NithanNguyen/receptionist_robot/meshes/hoverboard_motor_assembly.stl

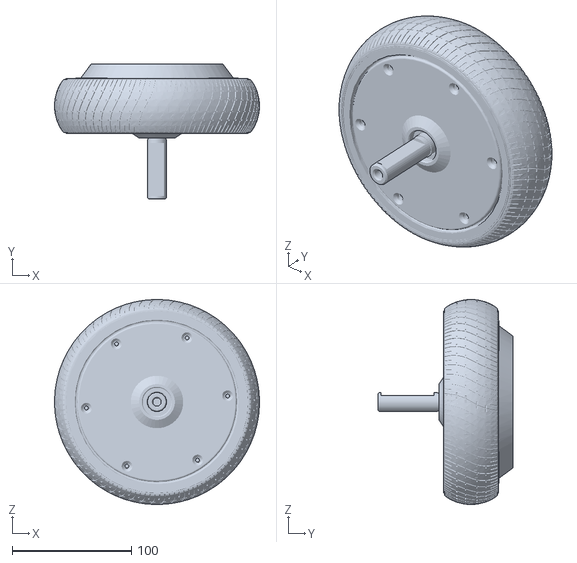
[picture p1: CAD file, 2026-10-13]
meshes/hoverboard_motor_assembly.stl
172.0 x 113.4 x 172.0
