NithanNguyen/receptionist_robot/meshes/RPLiDAR_s2.stl

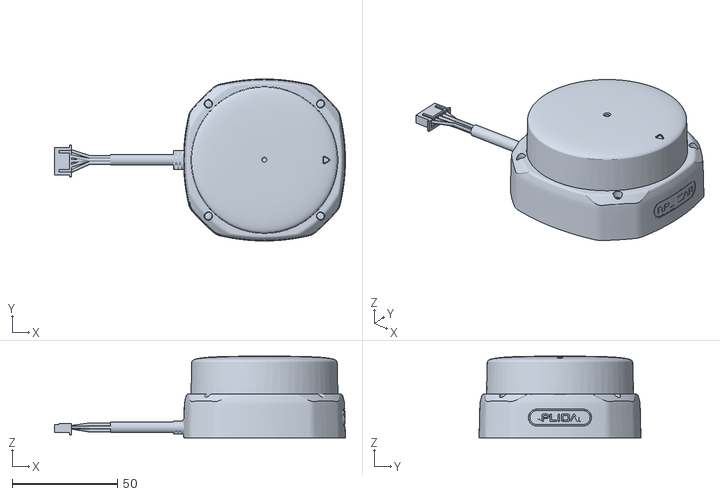
[picture p2: CAD file, 2026-10-13]
meshes/RPLiDAR_s2.stl
138.3 x 77.0 x 38.9
