NithanNguyen/receptionist_robot/meshes/Model.stl

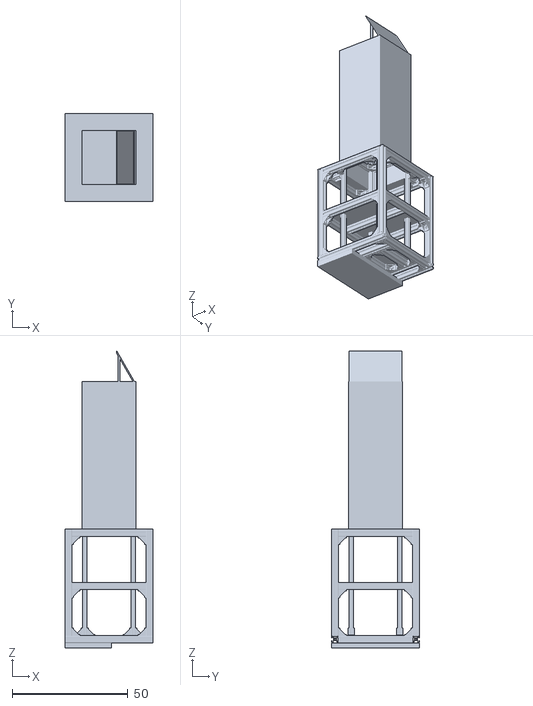
[picture p3: CAD file, 2026-10-13]
meshes/Model.stl
38.0 x 38.0 x 128.6
