NithanNguyen/receptionist_robot/meshes/BNO055_BPM280.stl

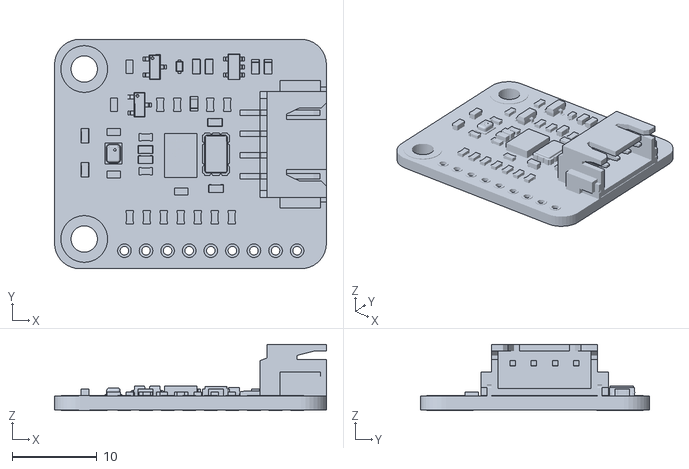
[picture p4: CAD file, 2026-10-13]
meshes/BNO055_BPM280.stl
32.0 x 27.0 x 7.80
