NithanNguyen/receptionist_robot/meshes/HY-SRF05.stl

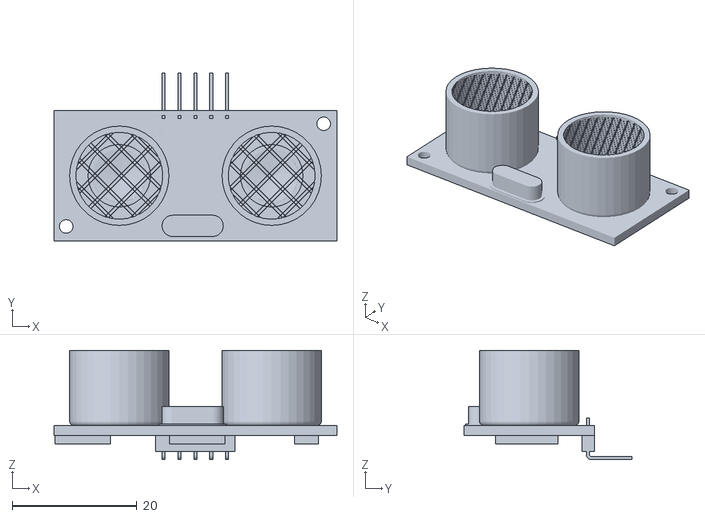
[picture p5: CAD file, 2026-10-13]
meshes/HY-SRF05.stl
45.3 x 26.8 x 17.5
