NithanNguyen/receptionist_robot/meshes/Model_v3.stl

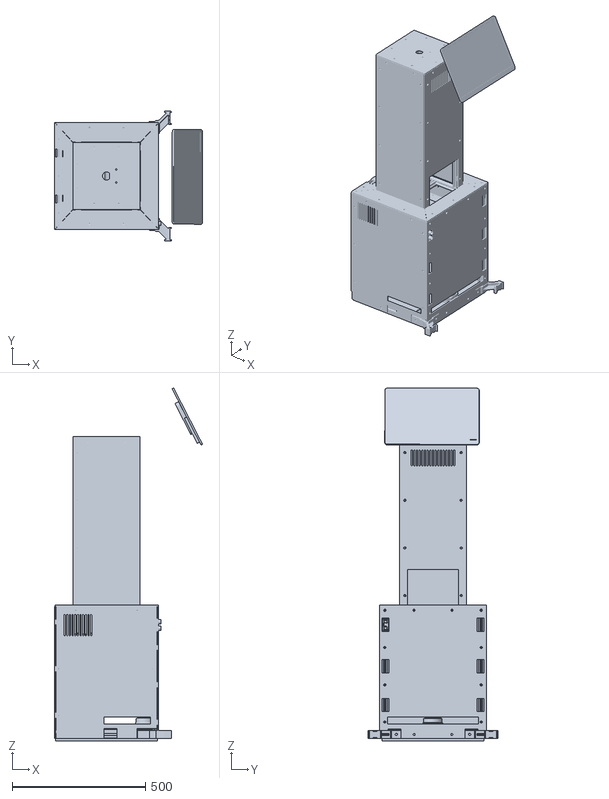
[picture p6: CAD file, 2026-10-13]
meshes/Model_v3.stl
556.7 x 486.8 x 1325.6
