NithanNguyen/receptionist_robot/meshes/wheel_left.stl

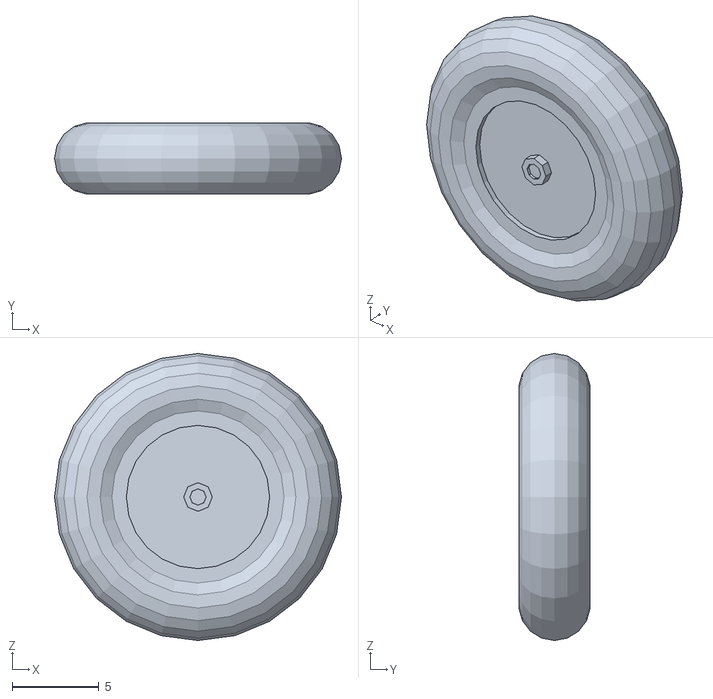
[picture p7: CAD file, 2026-10-13]
meshes/wheel_left.stl
16.5 x 4.11 x 16.5
