NithanNguyen/receptionist_robot/meshes/caster_wheel.stl

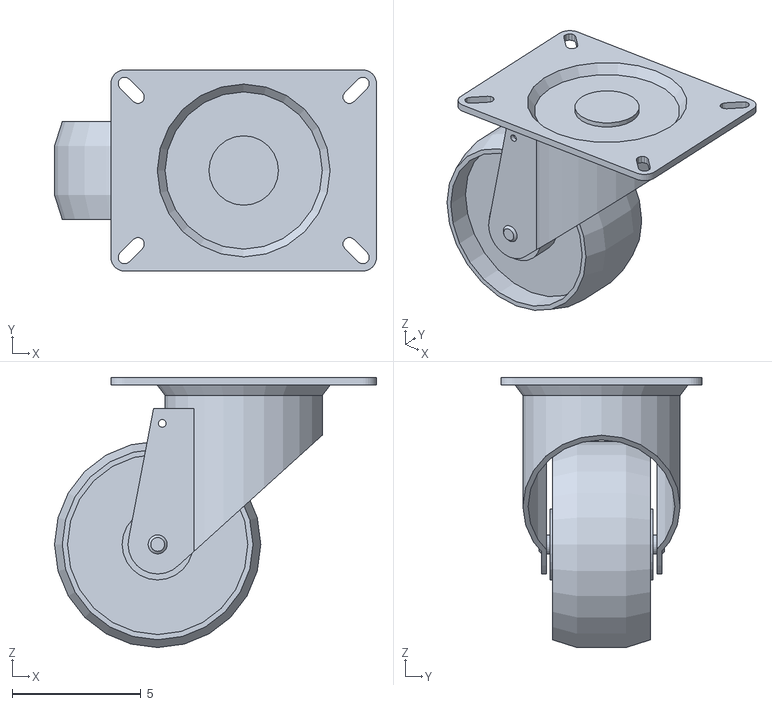
[picture p8: CAD file, 2026-10-13]
meshes/caster_wheel.stl
12.5 x 7.82 x 10.5
