NithanNguyen/receptionist_robot/meshes/Model_v2.stl

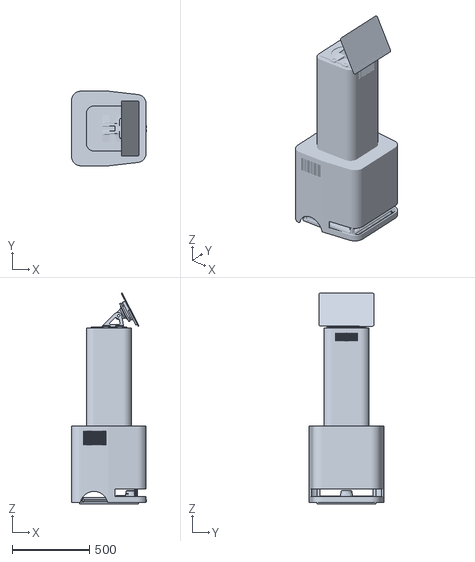
[picture p9: CAD file, 2026-10-13, an earlier design]
meshes/Model_v2.stl
484.0 x 482.0 x 1362.2
