NithanNguyen/receptionist_robot/meshes/Model_v1.stl

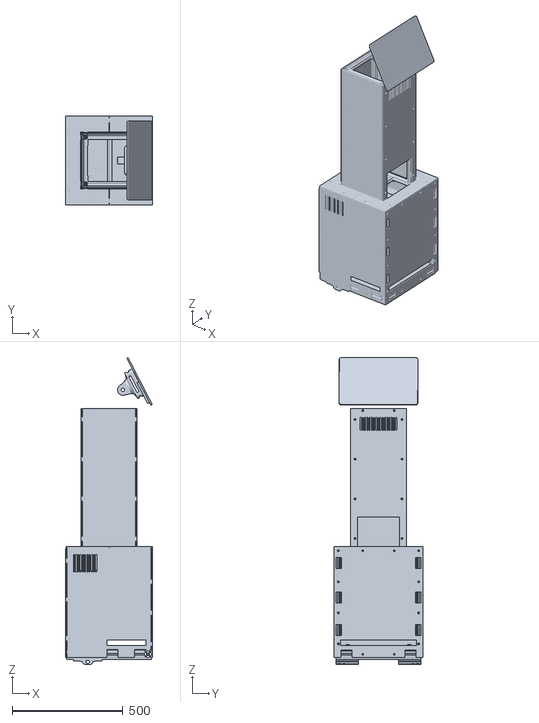
[picture p10: CAD file, 2026-10-13, an earlier design]
meshes/Model_v1.stl
391.9 x 402.0 x 1383.7
