NithanNguyen/receptionist_robot/(list of files, cad)

Other CAD files:
meshes/wheel_right.stl
