NithanNguyen/receptionist_robot/assets/document/User_Manual.docx

1. Chuẩn bị
  1.1. Power

Cắm pin Hoverboard, pin các Cảm biến, pin Màn hình, pin Jetson.

Bật tất cả công tắc (màu đỏ) của các pin.

  1.2. Ngoại vi

Đảm bảo tất các sensors và màn hình được kết nối với Jetson.

Bao gồm:

- LiDAR (LAN)
- IMU (I2C)
- Hoverboard (USB-A) thông qua module CP2102 - Mạch Chuyển Đổi USB To TTL UART
  - Nhấn button (bên hông, cạnh công tắc) để khởi động Hoverboard.

⇒ Kêu bíp bíp nghĩa là đã bật, chỉ khi di chuyển mới hết kêu.

- Ultrasonic (USB-A) - hiện tại chưa dùng được.
- Màn hình:
  - Cảm ứng (USB-A)
  - HDMI
- USB Wifi (USB-A): chỉ dùng cho chức năng chuyển file từ thiết bị khác sang Jetson (phải chung wifi với Jetson).
2. Pre-check

Cách 1: dùng UI

Nhấn pre_check trên desktop

Cách 2: dùng command

cd mbrobot_ws

./pre_check.sh

Lưu ý:

- Nếu chưa ping được LiDAR thì thực hiện lại cho đến khi được (3-4 lần) vì pha khởi động của LiDAR … hoặc dùng lệnh:

sudo ip addr add 192.168.11.1/24 dev enp2s0

sudo ip link set enp2s0 up

3. Run

Sau khi đảm bảo đã thực hiện các bước trên:

- Bước 1: Đặt robot đúng với Initial Pose đã xác định (Trước Thang máy và quay lưng với phía Thang máy).

Hình 1: Initial Pose

- Bước 2: Nhấn start_nav.sh trên desktop, nếu không báo lỗi gì và hiện ra dòng bên dưới là OK.
- Bước 3: Nhấn … trên desktop để mở App và sử dụng.

Nếu robot chạy không ổn định hoặc sai thì dừng chương trình của 2 bước trên rồi chạy lại.

# Troubleshooting

Per-subsystem bring-up checks. Run each one in isolation before blaming the full stack — the launch files start ten processes and a single silent device makes the failure look like a Nav2 problem.

Commands assume the workspace is at ~/mbrobot_ws and has been sourced:

source ~/mbrobot_ws/install/setup.bash

## Pre-flight check

pre_check.sh runs six phases: build, system prerequisites, hardware and devices, ROS topics and TF, configuration files for the selected floor, and disk / memory / temperature.

./pre_check.sh --help

./pre_check.sh --floor e6 # full check, floor e6

./pre_check.sh --floor e1 --skip-build # skip the colcon build phase

./pre_check.sh --floor e6 --check-topics # also launch nodes and measure topic rates

Phase 0 rebuilds the workspace and phase 3 with --check-topics launches nodes in the background, so this is not a read-only script.

## LiDAR link

The RPLIDAR S2E is reached over Ethernet/UDP. The Jetson interface needs a static address on the sensor's subnet before sllidar_node can connect. Replace the interface name with whichever one is wired to the sensor:

sudo ip addr add 192.168.11.1/24 dev enp2s0

sudo ip link set enp2s0 up

Then check the scan is flowing:

ros2 topic hz /scan

ros2 topic hz /scan_filtered

If /scan is alive but /scan_filtered is not, the filter chain is failing its TF lookup to base_footprint rather than the LiDAR being at fault.

## Ultrasonic bridge

Run the bridge directly to see the raw frames arriving from the ESP32:

python3 src/mobile_robot/scripts/jetson_sensor_bridge.py --debug

A frame is accepted only if it starts with $, contains *, carries exactly six fields, and matches its XOR checksum. Silent output with no errors means the port opened but nothing is being received — check /dev/ttyUltrasonic and the ESP32.

ros2 topic echo /ultrasonic/us_top_left

ros2 topic hz /ultrasonic_scan

## IMU

ros2 run bno055 bno055 \

--ros-args \

--params-file src/mobile_robot/config/bno055_params.yaml \

--remap /imu/imu:=/imu/data

In a second terminal:

ros2 topic list | grep imu # expect /imu/data /imu/mag /imu/temp /imu/calib_status

ros2 topic echo /imu/data

ros2 topic hz /imu/data

The remap matters: without it the driver publishes on /imu/imu and the EKF subscribes to nothing.

## Wheel odometry

ros2 run mobile_robot wheel_odom_node \

--ros-args --params-file src/mobile_robot/config/wheel_odom_params.yaml

ros2 topic hz /odom

ros2 topic echo /odom

The node opens /dev/ttyWheel once at startup and does not reconnect, so a serial error leaves the node alive but permanently silent. Restart it rather than waiting.

## EKF

ros2 run robot_localization ekf_node \

--ros-args --params-file src/mobile_robot/config/ekf.yaml

ros2 topic echo /odometry/filtered

The EKF is the only publisher of TF odom -> base_footprint. If that transform is missing, check that wheel_odom_node has publish_tf: false and that both /odom and /imu/data are live — the filter will not publish until it has an input.

## Inspecting the running graph

ros2 node list

ros2 node list | grep server # Nav2 lifecycle servers only

rqt_graph

ros2 param get /bt_navigator default_bt_xml_filename

ros2 run tf2_tools view_frames

## Common ordering symptom

canTransform warnings in the first seconds of a run are expected: Nav2 activates at t=12 s while global_localizer only starts at t=14 s, so there is a short window with no map -> odom transform. Warnings that persist past roughly t=20 s are a real localization failure, not a start-up artefact.

# Mapping

slam.launch.py brings up the hardware, the EKF and slam_toolbox in online_async mode. It starts no teleop node, so drive the robot manually:

ros2 run teleop_twist_keyboard teleop_twist_keyboard

run_slam.sh wraps the launch file with bag recording and an automatic map save on exit:

./run_slam.sh --scenario S6 --speed 0.10 --run 01

./run_slam.sh --no-save-map --no-bag # dry run

./run_slam.sh --help

## Saving a map manually

Confirm the map topic is alive first:

ros2 topic hz /map

### Preferred: raise the timeout and match the QoS

slam_toolbox publishes /map with transient-local durability, and large maps exceed the map saver's default timeout. Set both:

ros2 run nav2_map_server map_saver_cli \

-f ~/mbrobot_ws/src/mobile_robot/maps/map_e6 \

--ros-args \

-p save_map_timeout:=60000 \

-p map_subscribe_transient_local:=true \

-p free_thresh_default:=0.25 \

-p occupied_thresh_default:=0.65

### Alternative: the slam_toolbox service

ros2 service call /slam_toolbox/save_map slam_toolbox/srv/SaveMap \

"name: {data: '$HOME/mbrobot_ws/src/mobile_robot/maps/map_e6'}"

## After saving

map_saver_cli writes a .pgm and a .yaml. Keep the image: key in the .yaml relative to the file itself so the map stays portable across machines:

image: map_e6.pgm

The floor launch argument selects maps/map_<floor>.yaml together with config/checkpoints_<floor>.yaml, so a new map needs a matching checkpoint file before navigator can use it.

scripts/tools/save_checkpoints.py captures poses from /amcl_pose on each ENTER keypress and writes them as JSON. navigator reads the YAML schema shown in the existing config/checkpoints_*.yaml files, so the captured output has to be converted before use.

Re-run colcon build after adding maps or checkpoints — the launch files read them from install/share/, not from the source tree.
